davidchencsl/ECE445-project/autolug/server.py

from flask import Flask, request
import json
import logging
log = logging.getLogger('werkzeug')
log.setLevel(logging.ERROR)

app = Flask(__name__)

@app.route('/api/stats', methods=['GET'])
def get_stats():
    return json.dumps({'l_speed': 0.5,
                        'r_speed': 0.5,
                        'l_pwm': 129,
                        'r_pwm': 129,
                        'distance': 0.5,
                       })

@app.route('/api/controls', methods=['POST'])
def set_controls():
    data = request.json
    print(data)
    return 'OK'

@app.route('/api/bbox', methods=['POST'])
def set_bbox(): 
    data = request.json
    print(data)
    return 'OK'

@app.route('/api/camera', methods=['GET'])
def get_camera():
    return json.dumps({'image': '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'})

@app.route('/api/stop', methods=['POST'])
def stop():
    print('STOP')
    return 'OK'

if __name__ == '__main__':
    app.run(host='0.0.0.0', port=6969)
