davidchencsl/ECE445-project/(commit log)

2023-04-10 add i2c
2023-04-11 add encoder
2023-04-25 add lidar
